thewonderidiot/agc_monitor/client/resources/dsky.png

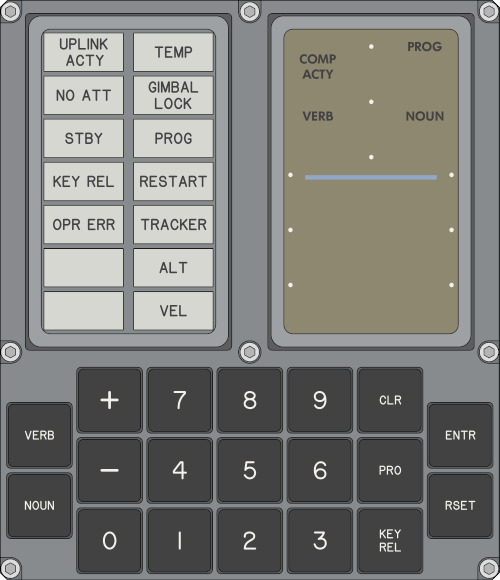
client/resources/dsky.png
