thewonderidiot/agc_monitor/client/resources/lamps.png

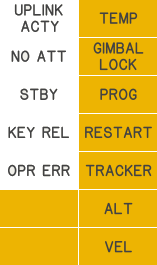
client/resources/lamps.png
