thewonderidiot/agc_monitor/(threads)

Thread 1 (2019-07-14):

Question: Using with yaAGC (virtual AGC)

jhuscott, 2019-07-14:
Hello,
Not having an FPGA to program at the moment (and looking at your files, it looks like a Styx Zynq 7020?), I am wondering if it is possible to point this monitor at yaAGC to debug and step through code.
I see you added code for NASSP, which uses yaAGC, but it looks to me that it is communicating with your actual AGC and not the simulated version.
Cheers.

meltdown03, 2022-07-04:
I was wondering the same thing. Do you also know if it's possible to use VirtualAGC to control Orbiter 2016 like in the videos of you landing on the (simulated) moon with the real AGC?

thewonderidiot, 2022-07-04:
Oops, I missed the original question here. :grimacing: Sorry! To answer both questions:

- No, it's not possible to point the monitor at yaAGC. yaAGC is an instruction-level emulator of the AGC; but in the real AGC, instructions are made up of 1-memory-cycle-time chunks called "subinstructions", which in turn are each made up of 12 "timepulses" that time execution of each subinstruction's control pulses (sort of like microcode -- see [AGC4 Memo #9](https://www.ibiblio.org/apollo/Documents/agc4_memo9_rev_june1967.pdf) for the control pulse definitions for each subinstruction). The test connector on the AGC directly exposes many of these control pulses as well as the contents of the "write bus" across which most data in the computer flows. Using that information, the monitor is able to reconstruct what's going on inside the computer. Much of the Monitor control panel and logic is based around this internal architecture, so it would be very difficult to interface it with an emulator that does not simulate this internal architecture... and if you did, a lot of the controls probably wouldn't work correctly.
- @meltdown03 for your second question -- the NASSP plugin already runs yaAGC out of the box! The installation guide is [here on the Orbiter forum](https://www.orbiter-forum.com/threads/nassp-8-installation-guide.36801/).

meltdown03, 2022-07-12:
Thanks for the info. Do all the missions use real AGC code now? I read on https://nassp.space/index.php?title=First_Steps that only some use the Virtual AGC.
