thewonderidiot/agc_monitor/board/agc_monitor.kicad_pcb

## KiCad design board/agc_monitor.kicad_pcb (2019-04-02)

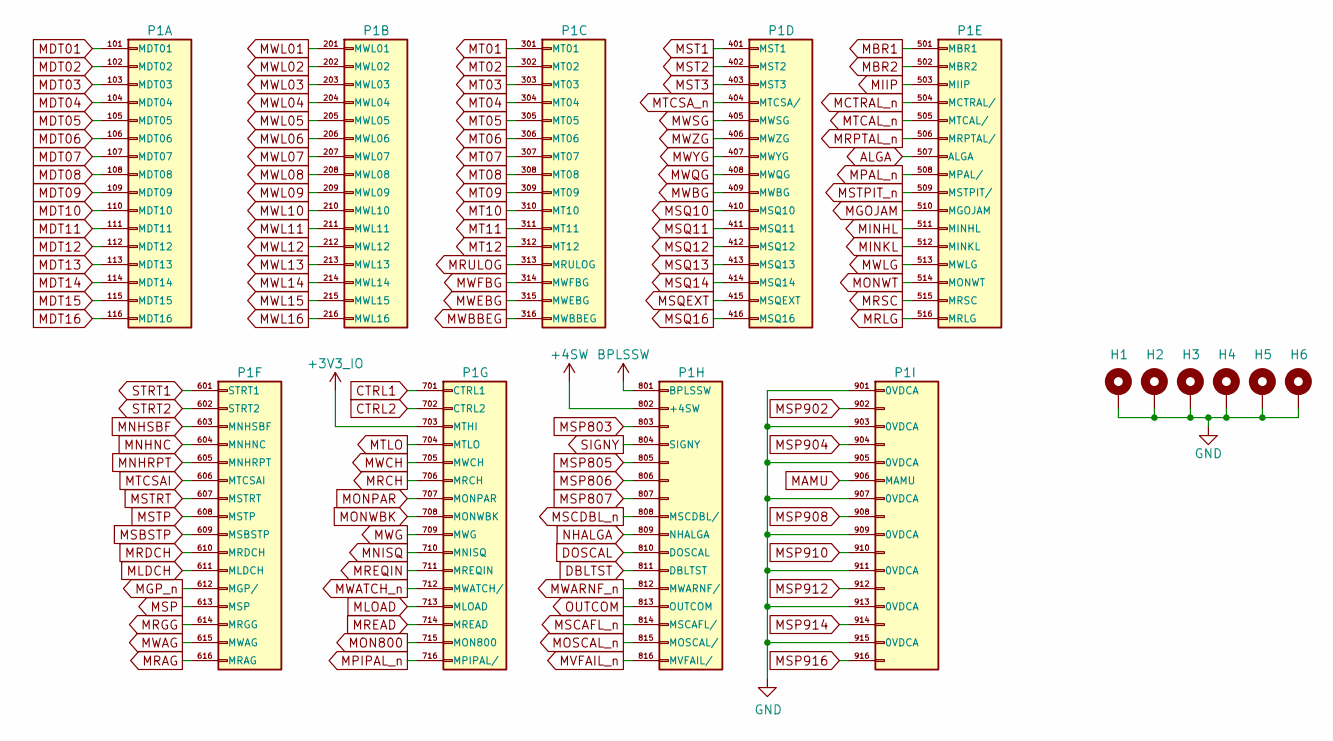
[picture p3: schematic test_connector.sch]

Parts:
H1, H2, H3, H4, H5, H6: MountingHole_Pad; MountingHole_ANSI_4
P1: test_connector

Connections:
+3V3_IO: P1.703 (MTHI); also elsewhere on the board
+4SW: P1.802 (+4SW); also elsewhere on the board
ALGA: P1.507 (ALGA); also elsewhere on the board
BPLSSW: P1.801 (BPLSSW); also elsewhere on the board
CTRL1: P1.701 (CTRL1); also elsewhere on the board
CTRL2: P1.702 (CTRL2); also elsewhere on the board
DBLTST: P1.811 (DBLTST); also elsewhere on the board
DOSCAL: P1.810 (DOSCAL); also elsewhere on the board
GND: H1.1, H2.1, H3.1, H4.1, H5.1, H6.1, P1.901 (0VDCA), P1.903 (0VDCA), P1.905 (0VDCA), P1.907 (0VDCA), P1.909 (0VDCA), P1.911 (0VDCA), P1.913 (0VDCA), P1.915 (0VDCA); also elsewhere on the board
MAMU: P1.906 (MAMU); also elsewhere on the board
MBR1: P1.501 (MBR1); also elsewhere on the board
MBR2: P1.502 (MBR2); also elsewhere on the board
MCTRAL_n: P1.504 (MCTRAL/); also elsewhere on the board
MDT01: P1.101 (MDT01); also elsewhere on the board
MDT02: P1.102 (MDT02); also elsewhere on the board
MDT03: P1.103 (MDT03); also elsewhere on the board
MDT04: P1.104 (MDT04); also elsewhere on the board
MDT05: P1.105 (MDT05); also elsewhere on the board
MDT06: P1.106 (MDT06); also elsewhere on the board
MDT07: P1.107 (MDT07); also elsewhere on the board
MDT08: P1.108 (MDT08); also elsewhere on the board
MDT09: P1.109 (MDT09); also elsewhere on the board
MDT10: P1.110 (MDT10); also elsewhere on the board
MDT11: P1.111 (MDT11); also elsewhere on the board
MDT12: P1.112 (MDT12); also elsewhere on the board
MDT13: P1.113 (MDT13); also elsewhere on the board
MDT14: P1.114 (MDT14); also elsewhere on the board
MDT15: P1.115 (MDT15); also elsewhere on the board
MDT16: P1.116 (MDT16); also elsewhere on the board
MGOJAM: P1.510 (MGOJAM); also elsewhere on the board
MGP_n: P1.612 (MGP/); also elsewhere on the board
MIIP: P1.503 (MIIP); also elsewhere on the board
MINHL: P1.511 (MINHL); also elsewhere on the board
MINKL: P1.512 (MINKL); also elsewhere on the board
MLDCH: P1.611 (MLDCH); also elsewhere on the board
MLOAD: P1.713 (MLOAD); also elsewhere on the board
MNHNC: P1.604 (MNHNC); also elsewhere on the board
MNHRPT: P1.605 (MNHRPT); also elsewhere on the board
MNHSBF: P1.603 (MNHSBF); also elsewhere on the board
MNISQ: P1.710 (MNISQ); also elsewhere on the board
MON800: P1.715 (MON800); also elsewhere on the board
MONPAR: P1.707 (MONPAR); also elsewhere on the board
MONWBK: P1.708 (MONWBK); also elsewhere on the board
MONWT: P1.514 (MONWT); also elsewhere on the board
MOSCAL_n: P1.815 (MOSCAL/); also elsewhere on the board
MPAL_n: P1.508 (MPAL/); also elsewhere on the board
MPIPAL_n: P1.716 (MPIPAL/); also elsewhere on the board
MRAG: P1.616 (MRAG); also elsewhere on the board
MRCH: P1.706 (MRCH); also elsewhere on the board
MRDCH: P1.610 (MRDCH); also elsewhere on the board
MREAD: P1.714 (MREAD); also elsewhere on the board
MREQIN: P1.711 (MREQIN); also elsewhere on the board
MRGG: P1.614 (MRGG); also elsewhere on the board
MRLG: P1.516 (MRLG); also elsewhere on the board
MRPTAL_n: P1.506 (MRPTAL/); also elsewhere on the board
MRSC: P1.515 (MRSC); also elsewhere on the board
MRULOG: P1.313 (MRULOG); also elsewhere on the board
MSBSTP: P1.609 (MSBSTP); also elsewhere on the board
MSCAFL_n: P1.814 (MSCAFL/); also elsewhere on the board
MSCDBL_n: P1.808 (MSCDBL/); also elsewhere on the board
MSP: P1.613 (MSP); also elsewhere on the board
MSP803: P1.803; also elsewhere on the board
MSP805: P1.805; also elsewhere on the board
MSP806: P1.806; also elsewhere on the board
MSP807: P1.807; also elsewhere on the board
MSP902: P1.902; also elsewhere on the board
MSP904: P1.904; also elsewhere on the board
MSP908: P1.908; also elsewhere on the board
MSP910: P1.910; also elsewhere on the board
MSP912: P1.912; also elsewhere on the board
MSP914: P1.914; also elsewhere on the board
MSP916: P1.916; also elsewhere on the board
MSQ10: P1.410 (MSQ10); also elsewhere on the board
MSQ11: P1.411 (MSQ11); also elsewhere on the board
MSQ12: P1.412 (MSQ12); also elsewhere on the board
MSQ13: P1.413 (MSQ13); also elsewhere on the board
MSQ14: P1.414 (MSQ14); also elsewhere on the board
MSQ16: P1.416 (MSQ16); also elsewhere on the board
MSQEXT: P1.415 (MSQEXT); also elsewhere on the board
MST1: P1.401 (MST1); also elsewhere on the board
MST2: P1.402 (MST2); also elsewhere on the board
MST3: P1.403 (MST3); also elsewhere on the board
MSTP: P1.608 (MSTP); also elsewhere on the board
MSTPIT_n: P1.509 (MSTPIT/); also elsewhere on the board
MSTRT: P1.607 (MSTRT); also elsewhere on the board
MT01: P1.301 (MT01); also elsewhere on the board
MT02: P1.302 (MT02); also elsewhere on the board
MT03: P1.303 (MT03); also elsewhere on the board
MT04: P1.304 (MT04); also elsewhere on the board
MT05: P1.305 (MT05); also elsewhere on the board
MT06: P1.306 (MT06); also elsewhere on the board
MT07: P1.307 (MT07); also elsewhere on the board
MT08: P1.308 (MT08); also elsewhere on the board
MT09: P1.309 (MT09); also elsewhere on the board
MT10: P1.310 (MT10); also elsewhere on the board
MT11: P1.311 (MT11); also elsewhere on the board
MT12: P1.312 (MT12); also elsewhere on the board
MTCAL_n: P1.505 (MTCAL/); also elsewhere on the board
MTCSAI: P1.606 (MTCSAI); also elsewhere on the board
MTCSA_n: P1.404 (MTCSA/); also elsewhere on the board
MTLO: P1.704 (MTLO); also elsewhere on the board
MVFAIL_n: P1.816 (MVFAIL/); also elsewhere on the board
MWAG: P1.615 (MWAG); also elsewhere on the board
MWARNF_n: P1.812 (MWARNF/); also elsewhere on the board
MWATCH_n: P1.712 (MWATCH/); also elsewhere on the board
MWBBEG: P1.316 (MWBBEG); also elsewhere on the board
MWBG: P1.409 (MWBG); also elsewhere on the board
MWCH: P1.705 (MWCH); also elsewhere on the board
MWEBG: P1.315 (MWEBG); also elsewhere on the board
MWFBG: P1.314 (MWFBG); also elsewhere on the board
MWG: P1.709 (MWG); also elsewhere on the board
MWL01: P1.201 (MWL01); also elsewhere on the board
MWL02: P1.202 (MWL02); also elsewhere on the board
MWL03: P1.203 (MWL03); also elsewhere on the board
MWL04: P1.204 (MWL04); also elsewhere on the board
MWL05: P1.205 (MWL05); also elsewhere on the board
MWL06: P1.206 (MWL06); also elsewhere on the board
MWL07: P1.207 (MWL07); also elsewhere on the board
MWL08: P1.208 (MWL08); also elsewhere on the board
MWL09: P1.209 (MWL09); also elsewhere on the board
MWL10: P1.210 (MWL10); also elsewhere on the board
MWL11: P1.211 (MWL11); also elsewhere on the board
MWL12: P1.212 (MWL12); also elsewhere on the board
MWL13: P1.213 (MWL13); also elsewhere on the board
MWL14: P1.214 (MWL14); also elsewhere on the board
MWL15: P1.215 (MWL15); also elsewhere on the board
MWL16: P1.216 (MWL16); also elsewhere on the board
MWLG: P1.513 (MWLG); also elsewhere on the board
MWQG: P1.408 (MWQG); also elsewhere on the board
MWSG: P1.405 (MWSG); also elsewhere on the board
MWYG: P1.407 (MWYG); also elsewhere on the board
MWZG: P1.406 (MWZG); also elsewhere on the board
NHALGA: P1.809 (NHALGA); also elsewhere on the board
OUTCOM: P1.813 (OUTCOM); also elsewhere on the board
SIGNY: P1.804 (SIGNY); also elsewhere on the board
STRT1: P1.601 (STRT1); also elsewhere on the board
STRT2: P1.602 (STRT2); also elsewhere on the board

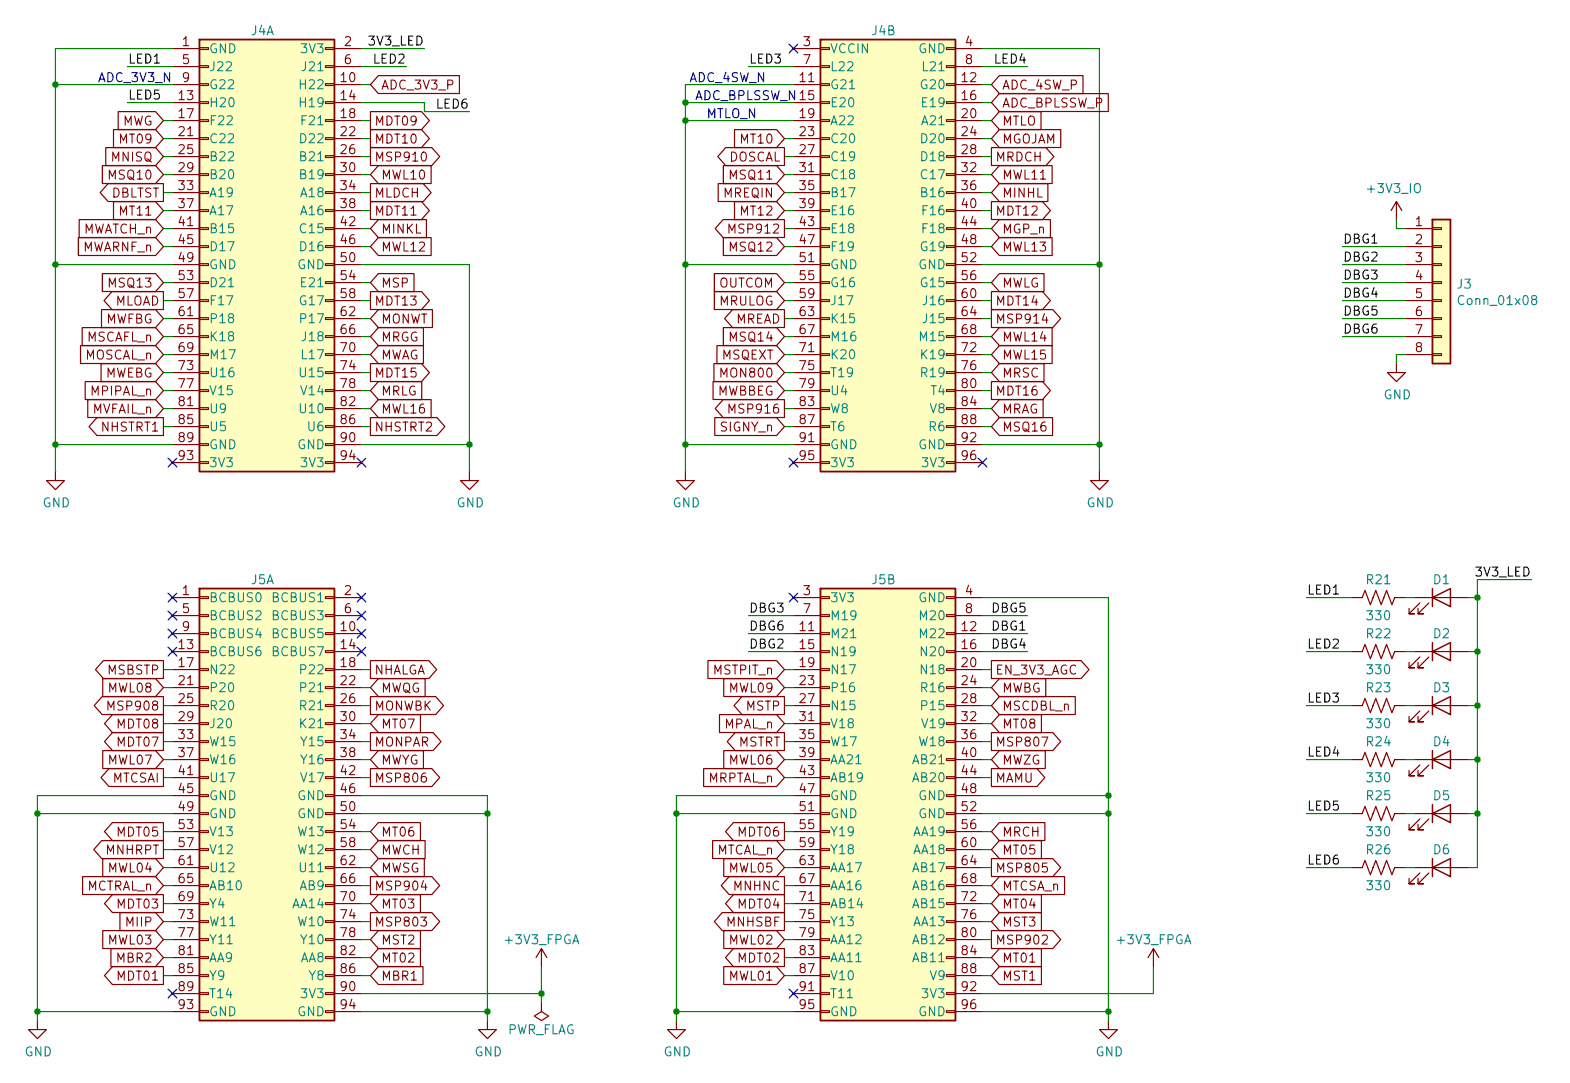
[picture p4: schematic styx_connectors.sch]

Parts:
D1, D2, D3, D4, D5, D6: LED; LED_0603_1608Metric
J3: Conn_01x08; PinSocket_2x04_P2.54mm_Horizontal
J4: Styx_P4; PinHeader_4x24_P2.54mm_Vertical
J5: Styx_P5; PinHeader_4x24_P2.54mm_Vertical
R21, R22, R23, R24, R25, R26: 330; R_0603_1608Metric

Connections:
+3V3_FPGA: J5.90 (3V3), J5.92 (3V3); also elsewhere on the board
+3V3_IO: J3.1; also elsewhere on the board
/StyxConnectors/3V3_LED: D1.2 (A), D2.2 (A), D3.2 (A), D4.2 (A), D5.2 (A), D6.2 (A), J4.2 (3V3)
/StyxConnectors/DBG1: J3.2, J5.12 (M22)
/StyxConnectors/DBG2: J3.3, J5.15 (N19)
/StyxConnectors/DBG3: J3.4, J5.7 (M19)
/StyxConnectors/DBG4: J3.5, J5.16 (N20)
/StyxConnectors/DBG5: J3.6, J5.8 (M20)
/StyxConnectors/DBG6: J3.7, J5.11 (M21)
/StyxConnectors/LED1: J4.5 (J22), R21.2
/StyxConnectors/LED2: J4.6 (J21), R22.2
/StyxConnectors/LED3: J4.7 (L22), R23.2
/StyxConnectors/LED4: J4.8 (L21), R24.2
/StyxConnectors/LED5: J4.13 (H20), R25.2
/StyxConnectors/LED6: J4.14 (H19), R26.2
ADC_3V3_P: J4.10 (H22); also elsewhere on the board
ADC_4SW_P: J4.12 (G20); also elsewhere on the board
ADC_BPLSSW_P: J4.16 (E19); also elsewhere on the board
DBLTST: J4.33 (A19); also elsewhere on the board
DOSCAL: J4.27 (C19); also elsewhere on the board
EN_3V3_AGC: J5.20 (N18); also elsewhere on the board
GND: J3.8, J4.1 (GND), J4.4 (GND), J4.9 (G22), J4.11 (G21), J4.15 (E20), J4.19 (A22), J4.49 (GND), J4.50 (GND), J4.51 (GND), J4.52 (GND), J4.89 (GND), J4.90 (GND), J4.91 (GND), J4.92 (GND), J5.4 (GND), J5.45 (GND), J5.46 (GND), J5.47 (GND), J5.48 (GND), J5.49 (GND), J5.50 (GND), J5.51 (GND), J5.52 (GND), J5.93 (GND), J5.94 (GND), J5.95 (GND), J5.96 (GND); also elsewhere on the board
MAMU: J5.44 (AB20); also elsewhere on the board
MBR1: J5.86 (Y8); also elsewhere on the board
MBR2: J5.81 (AA9); also elsewhere on the board
MCTRAL_n: J5.65 (AB10); also elsewhere on the board
MDT01: J5.85 (Y9); also elsewhere on the board
MDT02: J5.83 (AA11); also elsewhere on the board
MDT03: J5.69 (Y4); also elsewhere on the board
MDT04: J5.71 (AB14); also elsewhere on the board
MDT05: J5.53 (V13); also elsewhere on the board
MDT06: J5.55 (Y19); also elsewhere on the board
MDT07: J5.33 (W15); also elsewhere on the board
MDT08: J5.29 (J20); also elsewhere on the board
MDT09: J4.18 (F21); also elsewhere on the board
MDT10: J4.22 (D22); also elsewhere on the board
MDT11: J4.38 (A16); also elsewhere on the board
MDT12: J4.40 (F16); also elsewhere on the board
MDT13: J4.58 (G17); also elsewhere on the board
MDT14: J4.60 (J16); also elsewhere on the board
MDT15: J4.74 (U15); also elsewhere on the board
MDT16: J4.80 (T4); also elsewhere on the board
MGOJAM: J4.24 (D20); also elsewhere on the board
MGP_n: J4.44 (F18); also elsewhere on the board
MIIP: J5.73 (W11); also elsewhere on the board
MINHL: J4.36 (B16); also elsewhere on the board
MINKL: J4.42 (C15); also elsewhere on the board
MLDCH: J4.34 (A18); also elsewhere on the board
MLOAD: J4.57 (F17); also elsewhere on the board
MNHNC: J5.67 (AA16); also elsewhere on the board
MNHRPT: J5.57 (V12); also elsewhere on the board
MNHSBF: J5.75 (Y13); also elsewhere on the board
MNISQ: J4.25 (B22); also elsewhere on the board
MON800: J4.75 (T19); also elsewhere on the board
MONPAR: J5.34 (Y15); also elsewhere on the board
MONWBK: J5.26 (R21); also elsewhere on the board
MONWT: J4.62 (P17); also elsewhere on the board
MOSCAL_n: J4.69 (M17); also elsewhere on the board
MPAL_n: J5.31 (V18); also elsewhere on the board
MPIPAL_n: J4.77 (V15); also elsewhere on the board
MRAG: J4.84 (V8); also elsewhere on the board
MRCH: J5.56 (AA19); also elsewhere on the board
MRDCH: J4.28 (D18); also elsewhere on the board
MREAD: J4.63 (K15); also elsewhere on the board
MREQIN: J4.35 (B17); also elsewhere on the board
MRGG: J4.66 (J18); also elsewhere on the board
MRLG: J4.78 (V14); also elsewhere on the board
MRPTAL_n: J5.43 (AB19); also elsewhere on the board
MRSC: J4.76 (R19); also elsewhere on the board
MRULOG: J4.59 (J17); also elsewhere on the board
MSBSTP: J5.17 (N22); also elsewhere on the board
MSCAFL_n: J4.65 (K18); also elsewhere on the board
MSCDBL_n: J5.28 (P15); also elsewhere on the board
MSP: J4.54 (E21); also elsewhere on the board
MSP803: J5.74 (W10); also elsewhere on the board
MSP805: J5.64 (AB17); also elsewhere on the board
MSP806: J5.42 (V17); also elsewhere on the board
MSP807: J5.36 (W18); also elsewhere on the board
MSP902: J5.80 (AB12); also elsewhere on the board
MSP904: J5.66 (AB9); also elsewhere on the board
MSP908: J5.25 (R20); also elsewhere on the board
MSP910: J4.26 (B21); also elsewhere on the board
MSP912: J4.43 (E18); also elsewhere on the board
MSP914: J4.64 (J15); also elsewhere on the board
MSP916: J4.83 (W8); also elsewhere on the board
MSQ10: J4.29 (B20); also elsewhere on the board
MSQ11: J4.31 (C18); also elsewhere on the board
MSQ12: J4.47 (F19); also elsewhere on the board
MSQ13: J4.53 (D21); also elsewhere on the board
MSQ14: J4.67 (M16); also elsewhere on the board
MSQ16: J4.88 (R6); also elsewhere on the board
MSQEXT: J4.71 (K20); also elsewhere on the board
MST1: J5.88 (V9); also elsewhere on the board
MST2: J5.78 (Y10); also elsewhere on the board
MST3: J5.76 (AA13); also elsewhere on the board
MSTP: J5.27 (N15); also elsewhere on the board
MSTPIT_n: J5.19 (N17); also elsewhere on the board
MSTRT: J5.35 (W17); also elsewhere on the board
MT01: J5.84 (AB11); also elsewhere on the board
MT02: J5.82 (AA8); also elsewhere on the board
MT03: J5.70 (AA14); also elsewhere on the board
MT04: J5.72 (AB15); also elsewhere on the board
MT05: J5.60 (AA18); also elsewhere on the board
MT06: J5.54 (W13); also elsewhere on the board
MT07: J5.30 (K21); also elsewhere on the board
MT08: J5.32 (V19); also elsewhere on the board
MT09: J4.21 (C22); also elsewhere on the board
MT10: J4.23 (C20); also elsewhere on the board
MT11: J4.37 (A17); also elsewhere on the board
MT12: J4.39 (E16); also elsewhere on the board
MTCAL_n: J5.59 (Y18); also elsewhere on the board
MTCSAI: J5.41 (U17); also elsewhere on the board
MTCSA_n: J5.68 (AB16); also elsewhere on the board
MTLO: J4.20 (A21); also elsewhere on the board
MVFAIL_n: J4.81 (U9); also elsewhere on the board
MWAG: J4.70 (L17); also elsewhere on the board
MWARNF_n: J4.45 (D17); also elsewhere on the board
MWATCH_n: J4.41 (B15); also elsewhere on the board
MWBBEG: J4.79 (U4); also elsewhere on the board
MWBG: J5.24 (R16); also elsewhere on the board
MWCH: J5.58 (W12); also elsewhere on the board
MWEBG: J4.73 (U16); also elsewhere on the board
MWFBG: J4.61 (P18); also elsewhere on the board
MWG: J4.17 (F22); also elsewhere on the board
MWL01: J5.87 (V10); also elsewhere on the board
MWL02: J5.79 (AA12); also elsewhere on the board
MWL03: J5.77 (Y11); also elsewhere on the board
MWL04: J5.61 (U12); also elsewhere on the board
MWL05: J5.63 (AA17); also elsewhere on the board
MWL06: J5.39 (AA21); also elsewhere on the board
MWL07: J5.37 (W16); also elsewhere on the board
MWL08: J5.21 (P20); also elsewhere on the board
MWL09: J5.23 (P16); also elsewhere on the board
MWL10: J4.30 (B19); also elsewhere on the board
MWL11: J4.32 (C17); also elsewhere on the board
MWL12: J4.46 (D16); also elsewhere on the board
MWL13: J4.48 (G19); also elsewhere on the board
MWL14: J4.68 (M15); also elsewhere on the board
MWL15: J4.72 (K19); also elsewhere on the board
MWL16: J4.82 (U10); also elsewhere on the board
MWLG: J4.56 (G15); also elsewhere on the board
MWQG: J5.22 (P21); also elsewhere on the board
MWSG: J5.62 (U11); also elsewhere on the board
MWYG: J5.38 (Y16); also elsewhere on the board
MWZG: J5.40 (AB21); also elsewhere on the board
NHALGA: J5.18 (P22); also elsewhere on the board
NHSTRT1: J4.85 (U5); also elsewhere on the board
NHSTRT2: J4.86 (U6); also elsewhere on the board
unnamed: D1.1 (K), R21.1
unnamed: D2.1 (K), R22.1
unnamed: D3.1 (K), R23.1
unnamed: D4.1 (K), R24.1
unnamed: D5.1 (K), R25.1
unnamed: D6.1 (K), R26.1
OUTCOM: J4.55 (G16); also elsewhere on the board
SIGNY_n: J4.87 (T6); also elsewhere on the board

Notes on the sheet:
ADC_BPLSSW_N
ADC_4SW_N
MTLO_N
ADC_3V3_N

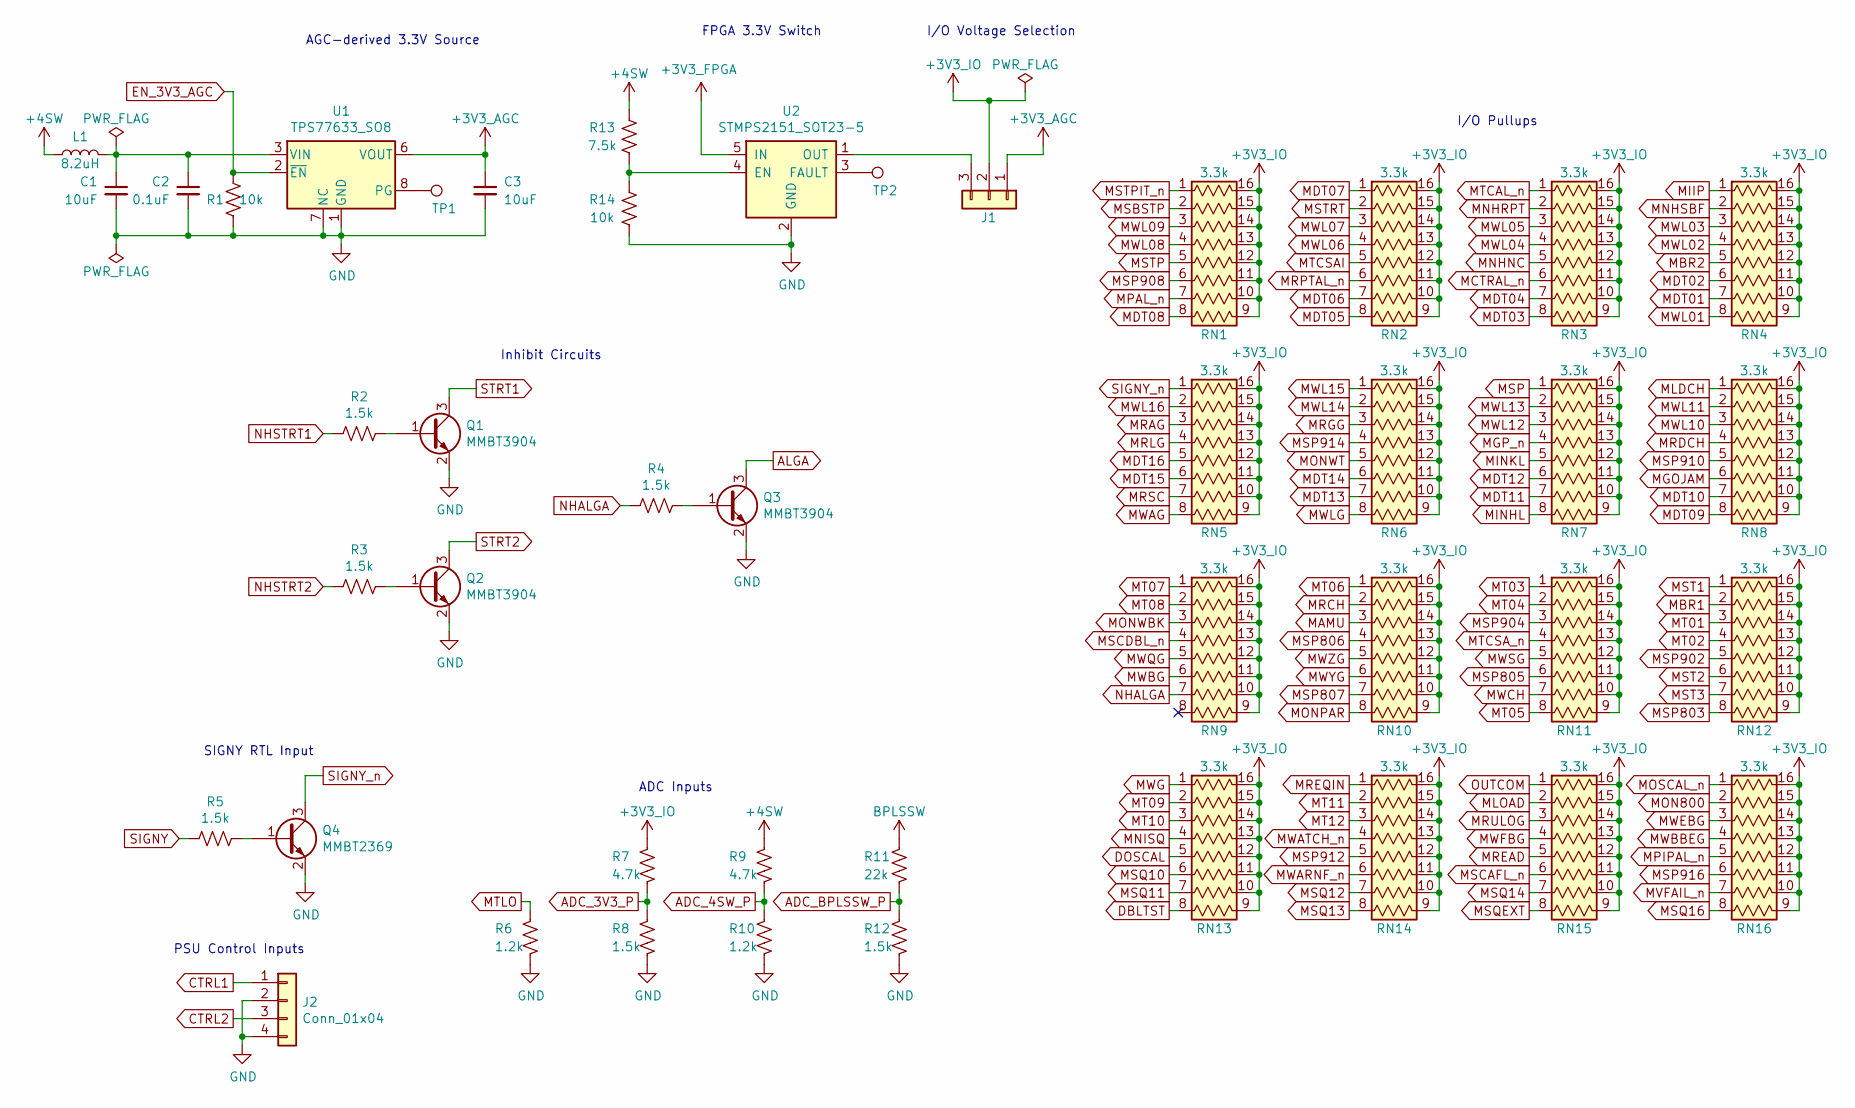
[picture p5: schematic interface_circuits.sch]

Parts:
C1, C3: 10uF; C_1206_3216Metric
C2: 0.1uF; C_0603_1608Metric
J1: Conn_01x03; PinHeader_1x03_P2.00mm_Vertical
J2: Conn_01x04; PinSocket_2x02_P2.54mm_Horizontal
L1: 8.2uH; L_1812_4532Metric
Q1, Q2, Q3: MMBT3904; SOT-23
Q4: MMBT2369; SOT-23
R1, R14: 10k; R_0603_1608Metric
R2, R3, R4, R5, R8, R12: 1.5k; R_0603_1608Metric
R6, R10: 1.2k; R_0603_1608Metric
R7, R9: 4.7k; R_0603_1608Metric
R11: 22k; R_0603_1608Metric
R13: 7.5k; R_0603_1608Metric
RN1, RN2, RN3, RN4, RN5, RN6, RN7, RN8, RN9, RN10, RN11, RN12, RN13, RN14, RN15, RN16: 3.3k; SOIC-16W_5.3x10.2mm_P1.27mm
TP1, TP2: TestPoint; TestPoint_Pad_D1.0mm
U1: TPS77633_SO8; SOIC-8_3.9x4.9mm_P1.27mm
U2: STMPS2151_SOT23-5; SOT-23-5

Connections:
+3V3_AGC: C3.1, J1.1, U1.5 (VOUT), U1.6 (VOUT)
+3V3_FPGA: U2.5 (IN); also elsewhere on the board
+3V3_IO: J1.2, R7.1, RN1.9 (R8B), RN1.10 (R7B), RN1.11 (R6B), RN1.12 (R5B), RN1.13 (R4B), RN1.14 (R3B), RN1.15 (R2B), RN1.16 (R1B), RN2.9 (R8B), RN2.10 (R7B), RN2.11 (R6B), RN2.12 (R5B), RN2.13 (R4B), RN2.14 (R3B), RN2.15 (R2B), RN2.16 (R1B), RN3.9 (R8B), RN3.10 (R7B), RN3.11 (R6B), RN3.12 (R5B), RN3.13 (R4B), RN3.14 (R3B), RN3.15 (R2B), RN3.16 (R1B), RN4.9 (R8B), RN4.10 (R7B), RN4.11 (R6B), RN4.12 (R5B), RN4.13 (R4B), RN4.14 (R3B), RN4.15 (R2B), RN4.16 (R1B), RN5.9 (R8B), RN5.10 (R7B), RN5.11 (R6B), RN5.12 (R5B), RN5.13 (R4B), RN5.14 (R3B), RN5.15 (R2B), RN5.16 (R1B), RN6.9 (R8B), RN6.10 (R7B), RN6.11 (R6B), RN6.12 (R5B), RN6.13 (R4B), RN6.14 (R3B), RN6.15 (R2B), RN6.16 (R1B), RN7.9 (R8B), RN7.10 (R7B), RN7.11 (R6B), RN7.12 (R5B), RN7.13 (R4B), RN7.14 (R3B), RN7.15 (R2B), RN7.16 (R1B), RN8.9 (R8B), RN8.10 (R7B), RN8.11 (R6B), RN8.12 (R5B), RN8.13 (R4B), RN8.14 (R3B), RN8.15 (R2B), RN8.16 (R1B), RN9.9 (R8B), RN9.10 (R7B), RN9.11 (R6B), RN9.12 (R5B), RN9.13 (R4B), RN9.14 (R3B), RN9.15 (R2B), RN9.16 (R1B), RN10.9 (R8B), RN10.10 (R7B), RN10.11 (R6B), RN10.12 (R5B), RN10.13 (R4B), RN10.14 (R3B), RN10.15 (R2B), RN10.16 (R1B), RN11.9 (R8B), RN11.10 (R7B), RN11.11 (R6B), RN11.12 (R5B), RN11.13 (R4B), RN11.14 (R3B), RN11.15 (R2B), RN11.16 (R1B), RN12.9 (R8B), RN12.10 (R7B), RN12.11 (R6B), RN12.12 (R5B), RN12.13 (R4B), RN12.14 (R3B), RN12.15 (R2B), RN12.16 (R1B), RN13.9 (R8B), RN13.10 (R7B), RN13.11 (R6B), RN13.12 (R5B), RN13.13 (R4B), RN13.14 (R3B), RN13.15 (R2B), RN13.16 (R1B), RN14.9 (R8B), RN14.10 (R7B), RN14.11 (R6B), RN14.12 (R5B), RN14.13 (R4B), RN14.14 (R3B), RN14.15 (R2B), RN14.16 (R1B), RN15.9 (R8B), RN15.10 (R7B), RN15.11 (R6B), RN15.12 (R5B), RN15.13 (R4B), RN15.14 (R3B), RN15.15 (R2B), RN15.16 (R1B), RN16.9 (R8B), RN16.10 (R7B), RN16.11 (R6B), RN16.12 (R5B), RN16.13 (R4B), RN16.14 (R3B), RN16.15 (R2B), RN16.16 (R1B); also elsewhere on the board
+4SW: L1.1, R9.1, R13.1; also elsewhere on the board
ADC_3V3_P: R7.2, R8.1; also elsewhere on the board
ADC_4SW_P: R9.2, R10.1; also elsewhere on the board
ADC_BPLSSW_P: R11.2, R12.1; also elsewhere on the board
ALGA: Q3.3 (C); also elsewhere on the board
BPLSSW: R11.1; also elsewhere on the board
CTRL1: J2.1; also elsewhere on the board
CTRL2: J2.3; also elsewhere on the board
DBLTST: RN13.8 (R8A); also elsewhere on the board
DOSCAL: RN13.5 (R5A); also elsewhere on the board
EN_3V3_AGC: R1.1, U1.2 (~EN~); also elsewhere on the board
GND: C1.2, C2.2, C3.2, J2.2, J2.4, Q1.2 (E), Q2.2 (E), Q3.2 (E), Q4.2 (E), R1.2, R6.2, R8.2, R10.2, R12.2, R14.2, U1.1 (GND), U1.7 (NC), U2.2 (GND); also elsewhere on the board
MAMU: RN10.3 (R3A); also elsewhere on the board
MBR1: RN12.2 (R2A); also elsewhere on the board
MBR2: RN4.5 (R5A); also elsewhere on the board
MCTRAL_n: RN3.6 (R6A); also elsewhere on the board
MDT01: RN4.7 (R7A); also elsewhere on the board
MDT02: RN4.6 (R6A); also elsewhere on the board
MDT03: RN3.8 (R8A); also elsewhere on the board
MDT04: RN3.7 (R7A); also elsewhere on the board
MDT05: RN2.8 (R8A); also elsewhere on the board
MDT06: RN2.7 (R7A); also elsewhere on the board
MDT07: RN2.1 (R1A); also elsewhere on the board
MDT08: RN1.8 (R8A); also elsewhere on the board
MDT09: RN8.8 (R8A); also elsewhere on the board
MDT10: RN8.7 (R7A); also elsewhere on the board
MDT11: RN7.7 (R7A); also elsewhere on the board
MDT12: RN7.6 (R6A); also elsewhere on the board
MDT13: RN6.7 (R7A); also elsewhere on the board
MDT14: RN6.6 (R6A); also elsewhere on the board
MDT15: RN5.6 (R6A); also elsewhere on the board
MDT16: RN5.5 (R5A); also elsewhere on the board
MGOJAM: RN8.6 (R6A); also elsewhere on the board
MGP_n: RN7.4 (R4A); also elsewhere on the board
MIIP: RN4.1 (R1A); also elsewhere on the board
MINHL: RN7.8 (R8A); also elsewhere on the board
MINKL: RN7.5 (R5A); also elsewhere on the board
MLDCH: RN8.1 (R1A); also elsewhere on the board
MLOAD: RN15.2 (R2A); also elsewhere on the board
MNHNC: RN3.5 (R5A); also elsewhere on the board
MNHRPT: RN3.2 (R2A); also elsewhere on the board
MNHSBF: RN4.2 (R2A); also elsewhere on the board
MNISQ: RN13.4 (R4A); also elsewhere on the board
MON800: RN16.2 (R2A); also elsewhere on the board
MONPAR: RN10.8 (R8A); also elsewhere on the board
MONWBK: RN9.3 (R3A); also elsewhere on the board
MONWT: RN6.5 (R5A); also elsewhere on the board
MOSCAL_n: RN16.1 (R1A); also elsewhere on the board
MPAL_n: RN1.7 (R7A); also elsewhere on the board
MPIPAL_n: RN16.5 (R5A); also elsewhere on the board
MRAG: RN5.3 (R3A); also elsewhere on the board
MRCH: RN10.2 (R2A); also elsewhere on the board
MRDCH: RN8.4 (R4A); also elsewhere on the board
MREAD: RN15.5 (R5A); also elsewhere on the board
MREQIN: RN14.1 (R1A); also elsewhere on the board
MRGG: RN6.3 (R3A); also elsewhere on the board
MRLG: RN5.4 (R4A); also elsewhere on the board
MRPTAL_n: RN2.6 (R6A); also elsewhere on the board
MRSC: RN5.7 (R7A); also elsewhere on the board
MRULOG: RN15.3 (R3A); also elsewhere on the board
MSBSTP: RN1.2 (R2A); also elsewhere on the board
MSCAFL_n: RN15.6 (R6A); also elsewhere on the board
MSCDBL_n: RN9.4 (R4A); also elsewhere on the board
MSP: RN7.1 (R1A); also elsewhere on the board
MSP803: RN12.8 (R8A); also elsewhere on the board
MSP805: RN11.6 (R6A); also elsewhere on the board
MSP806: RN10.4 (R4A); also elsewhere on the board
MSP807: RN10.7 (R7A); also elsewhere on the board
MSP902: RN12.5 (R5A); also elsewhere on the board
MSP904: RN11.3 (R3A); also elsewhere on the board
MSP908: RN1.6 (R6A); also elsewhere on the board
MSP910: RN8.5 (R5A); also elsewhere on the board
MSP912: RN14.5 (R5A); also elsewhere on the board
MSP914: RN6.4 (R4A); also elsewhere on the board
MSP916: RN16.6 (R6A); also elsewhere on the board
MSQ10: RN13.6 (R6A); also elsewhere on the board
MSQ11: RN13.7 (R7A); also elsewhere on the board
MSQ12: RN14.7 (R7A); also elsewhere on the board
MSQ13: RN14.8 (R8A); also elsewhere on the board
MSQ14: RN15.7 (R7A); also elsewhere on the board
MSQ16: RN16.8 (R8A); also elsewhere on the board
MSQEXT: RN15.8 (R8A); also elsewhere on the board
MST1: RN12.1 (R1A); also elsewhere on the board
MST2: RN12.6 (R6A); also elsewhere on the board
MST3: RN12.7 (R7A); also elsewhere on the board
MSTP: RN1.5 (R5A); also elsewhere on the board
MSTPIT_n: RN1.1 (R1A); also elsewhere on the board
MSTRT: RN2.2 (R2A); also elsewhere on the board
MT01: RN12.3 (R3A); also elsewhere on the board
MT02: RN12.4 (R4A); also elsewhere on the board
MT03: RN11.1 (R1A); also elsewhere on the board
MT04: RN11.2 (R2A); also elsewhere on the board
MT05: RN11.8 (R8A); also elsewhere on the board
MT06: RN10.1 (R1A); also elsewhere on the board
MT07: RN9.1 (R1A); also elsewhere on the board
MT08: RN9.2 (R2A); also elsewhere on the board
MT09: RN13.2 (R2A); also elsewhere on the board
MT10: RN13.3 (R3A); also elsewhere on the board
MT11: RN14.2 (R2A); also elsewhere on the board
MT12: RN14.3 (R3A); also elsewhere on the board
MTCAL_n: RN3.1 (R1A); also elsewhere on the board
MTCSAI: RN2.5 (R5A); also elsewhere on the board
MTCSA_n: RN11.4 (R4A); also elsewhere on the board
MTLO: R6.1; also elsewhere on the board
MVFAIL_n: RN16.7 (R7A); also elsewhere on the board
MWAG: RN5.8 (R8A); also elsewhere on the board
MWARNF_n: RN14.6 (R6A); also elsewhere on the board
MWATCH_n: RN14.4 (R4A); also elsewhere on the board
MWBBEG: RN16.4 (R4A); also elsewhere on the board
MWBG: RN9.6 (R6A); also elsewhere on the board
MWCH: RN11.7 (R7A); also elsewhere on the board
MWEBG: RN16.3 (R3A); also elsewhere on the board
MWFBG: RN15.4 (R4A); also elsewhere on the board
MWG: RN13.1 (R1A); also elsewhere on the board
MWL01: RN4.8 (R8A); also elsewhere on the board
MWL02: RN4.4 (R4A); also elsewhere on the board
MWL03: RN4.3 (R3A); also elsewhere on the board
MWL04: RN3.4 (R4A); also elsewhere on the board
MWL05: RN3.3 (R3A); also elsewhere on the board
MWL06: RN2.4 (R4A); also elsewhere on the board
MWL07: RN2.3 (R3A); also elsewhere on the board
MWL08: RN1.4 (R4A); also elsewhere on the board
MWL09: RN1.3 (R3A); also elsewhere on the board
MWL10: RN8.3 (R3A); also elsewhere on the board
MWL11: RN8.2 (R2A); also elsewhere on the board
MWL12: RN7.3 (R3A); also elsewhere on the board
MWL13: RN7.2 (R2A); also elsewhere on the board
MWL14: RN6.2 (R2A); also elsewhere on the board
MWL15: RN6.1 (R1A); also elsewhere on the board
MWL16: RN5.2 (R2A); also elsewhere on the board
MWLG: RN6.8 (R8A); also elsewhere on the board
MWQG: RN9.5 (R5A); also elsewhere on the board
MWSG: RN11.5 (R5A); also elsewhere on the board
MWYG: RN10.6 (R6A); also elsewhere on the board
MWZG: RN10.5 (R5A); also elsewhere on the board
NHALGA: R4.2, RN9.7 (R7A); also elsewhere on the board
NHSTRT1: R2.2; also elsewhere on the board
NHSTRT2: R3.2; also elsewhere on the board
unnamed: C1.1, C2.1, L1.2, U1.3 (VIN), U1.4 (VIN)
unnamed: J1.3, U2.1 (OUT)
unnamed: Q1.1 (B), R2.1
unnamed: Q2.1 (B), R3.1
unnamed: Q3.1 (B), R4.1
unnamed: Q4.1 (B), R5.1
unnamed: R13.2, R14.1, U2.4 (EN)
unnamed: TP1.1, U1.8 (PG)
unnamed: TP2.1, U2.3 (FAULT)
OUTCOM: RN15.1 (R1A); also elsewhere on the board
SIGNY: R5.2; also elsewhere on the board
SIGNY_n: Q4.3 (C), RN5.1 (R1A); also elsewhere on the board
STRT1: Q1.3 (C); also elsewhere on the board
STRT2: Q2.3 (C); also elsewhere on the board

Notes on the sheet:
AGC-derived 3.3V Source
I/O Voltage Selection
ADC Inputs
I/O Pullups
Inhibit Circuits
PSU Control Inputs
SIGNY RTL Input
FPGA 3.3V Switch

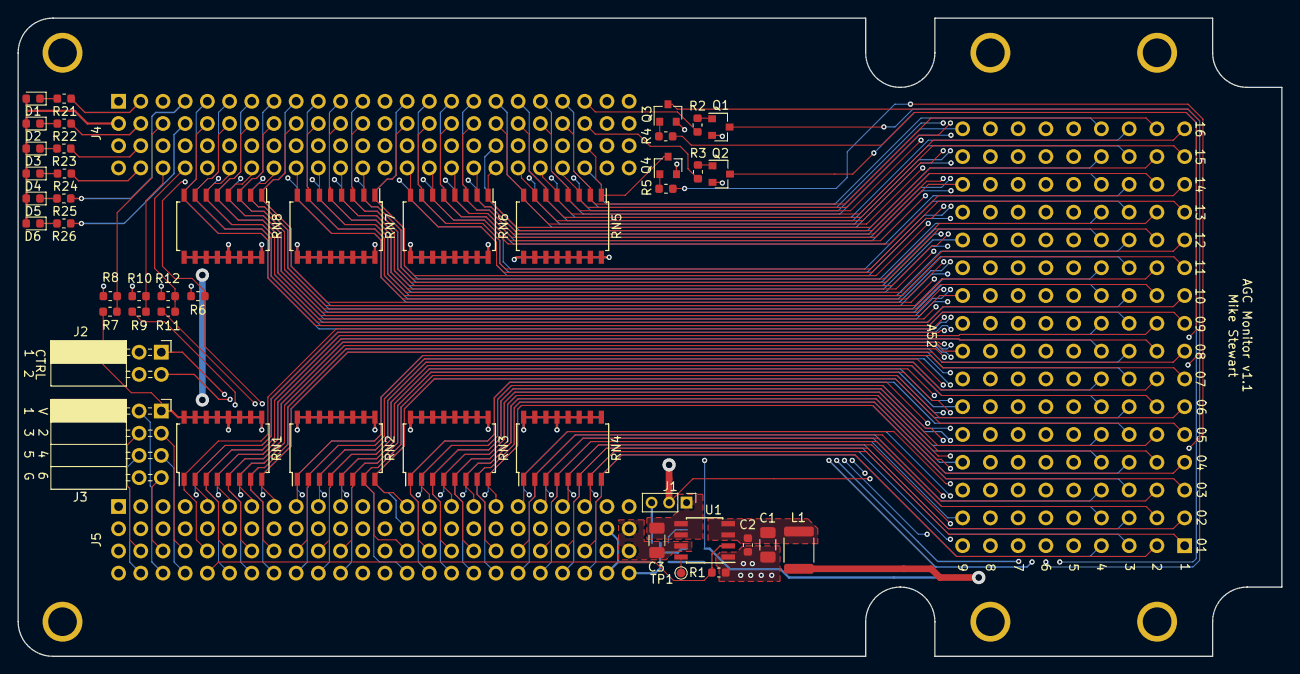
[picture p6: board agc_monitor.kicad_pcb from above]

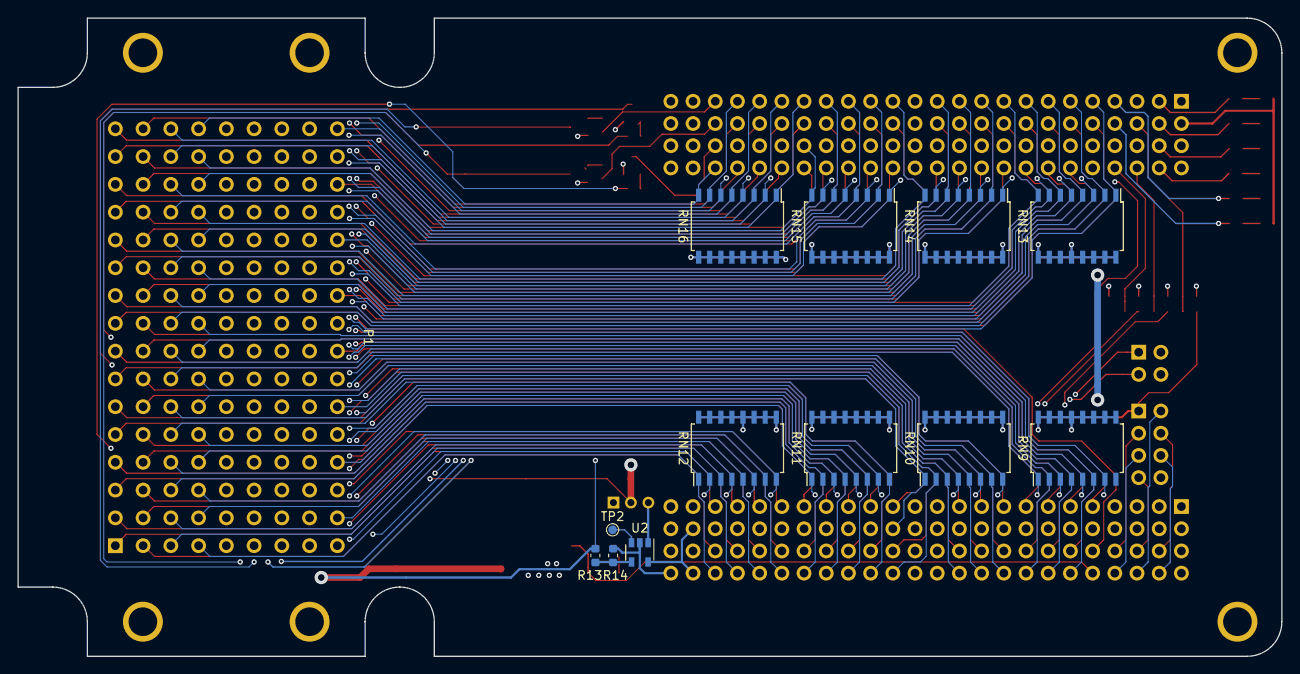
[picture p7: board agc_monitor.kicad_pcb from below]

Board: 4 copper layers, 144.6 x 73.0 mm, 66 parts (14 on the bottom side), 174 nets.
