thewonderidiot/agc_monitor/fpga/agc_monitor.runs/synth_1/.Xil/agc_monitor_propImpl.xdc

set_property SRC_FILE_INFO {cfile:/home/mike/agc_monitor/fpga/agc_monitor.srcs/constrs_1/new/agc_monitor.xdc rfile:../../../agc_monitor.srcs/constrs_1/new/agc_monitor.xdc id:1} [current_design]
set_property src_info {type:XDC file:1 line:2 export:INPUT save:INPUT read:READ} [current_design]
set_property PACKAGE_PIN Y6 [get_ports clk]
set_property src_info {type:XDC file:1 line:23 export:INPUT save:INPUT read:READ} [current_design]
set_property PACKAGE_PIN U20 [get_ports oe_n]
set_property src_info {type:XDC file:1 line:24 export:INPUT save:INPUT read:READ} [current_design]
set_property PACKAGE_PIN L18 [get_ports clkout]
set_property src_info {type:XDC file:1 line:25 export:INPUT save:INPUT read:READ} [current_design]
set_property PACKAGE_PIN Y20 [get_ports rd_n]
set_property src_info {type:XDC file:1 line:26 export:INPUT save:INPUT read:READ} [current_design]
set_property PACKAGE_PIN W20 [get_ports rxf_n]
set_property src_info {type:XDC file:1 line:27 export:INPUT save:INPUT read:READ} [current_design]
set_property PACKAGE_PIN V20 [get_ports siwu]
set_property src_info {type:XDC file:1 line:28 export:INPUT save:INPUT read:READ} [current_design]
set_property PACKAGE_PIN Y21 [get_ports txe_n]
set_property src_info {type:XDC file:1 line:29 export:INPUT save:INPUT read:READ} [current_design]
set_property PACKAGE_PIN W21 [get_ports wr_n]
set_property src_info {type:XDC file:1 line:31 export:INPUT save:INPUT read:READ} [current_design]
set_property PACKAGE_PIN T22 [get_ports {data[0]}]
set_property src_info {type:XDC file:1 line:32 export:INPUT save:INPUT read:READ} [current_design]
set_property PACKAGE_PIN T21 [get_ports {data[1]}]
set_property src_info {type:XDC file:1 line:33 export:INPUT save:INPUT read:READ} [current_design]
set_property PACKAGE_PIN U22 [get_ports {data[2]}]
set_property src_info {type:XDC file:1 line:34 export:INPUT save:INPUT read:READ} [current_design]
set_property PACKAGE_PIN U21 [get_ports {data[3]}]
set_property src_info {type:XDC file:1 line:35 export:INPUT save:INPUT read:READ} [current_design]
set_property PACKAGE_PIN V22 [get_ports {data[4]}]
set_property src_info {type:XDC file:1 line:36 export:INPUT save:INPUT read:READ} [current_design]
set_property PACKAGE_PIN W22 [get_ports {data[5]}]
set_property src_info {type:XDC file:1 line:37 export:INPUT save:INPUT read:READ} [current_design]
set_property PACKAGE_PIN AA22 [get_ports {data[6]}]
set_property src_info {type:XDC file:1 line:38 export:INPUT save:INPUT read:READ} [current_design]
set_property PACKAGE_PIN AB22 [get_ports {data[7]}]
set_property src_info {type:XDC file:1 line:82 export:INPUT save:INPUT read:READ} [current_design]
set_property PACKAGE_PIN AA16 [get_ports mnhnc]
set_property src_info {type:XDC file:1 line:83 export:INPUT save:INPUT read:READ} [current_design]
set_property PACKAGE_PIN P17 [get_ports monwt]
set_property src_info {type:XDC file:1 line:84 export:INPUT save:INPUT read:READ} [current_design]
set_property PACKAGE_PIN J18 [get_ports mrgg]
set_property src_info {type:XDC file:1 line:85 export:INPUT save:INPUT read:READ} [current_design]
set_property PACKAGE_PIN L17 [get_ports mwag]
set_property src_info {type:XDC file:1 line:86 export:INPUT save:INPUT read:READ} [current_design]
set_property PACKAGE_PIN R16 [get_ports mwbg]
set_property src_info {type:XDC file:1 line:87 export:INPUT save:INPUT read:READ} [current_design]
set_property PACKAGE_PIN F22 [get_ports mwg]
set_property src_info {type:XDC file:1 line:103 export:INPUT save:INPUT read:READ} [current_design]
set_property PACKAGE_PIN D20 [get_ports mgojam]
set_property src_info {type:XDC file:1 line:104 export:INPUT save:INPUT read:READ} [current_design]
set_property PACKAGE_PIN B22 [get_ports mnisq]
set_property src_info {type:XDC file:1 line:105 export:INPUT save:INPUT read:READ} [current_design]
set_property PACKAGE_PIN V18 [get_ports mpal_n]
set_property src_info {type:XDC file:1 line:106 export:INPUT save:INPUT read:READ} [current_design]
set_property PACKAGE_PIN AA19 [get_ports mrch]
set_property src_info {type:XDC file:1 line:107 export:INPUT save:INPUT read:READ} [current_design]
set_property PACKAGE_PIN K18 [get_ports mscafl_n]
set_property src_info {type:XDC file:1 line:108 export:INPUT save:INPUT read:READ} [current_design]
set_property PACKAGE_PIN N15 [get_ports mstp]
set_property src_info {type:XDC file:1 line:109 export:INPUT save:INPUT read:READ} [current_design]
set_property PACKAGE_PIN W17 [get_ports mstrt]
set_property src_info {type:XDC file:1 line:110 export:INPUT save:INPUT read:READ} [current_design]
set_property PACKAGE_PIN Y18 [get_ports mtcal_n]
set_property src_info {type:XDC file:1 line:111 export:INPUT save:INPUT read:READ} [current_design]
set_property PACKAGE_PIN U9 [get_ports mvfail_n]
set_property src_info {type:XDC file:1 line:112 export:INPUT save:INPUT read:READ} [current_design]
set_property PACKAGE_PIN B15 [get_ports mwatch_n]
set_property src_info {type:XDC file:1 line:113 export:INPUT save:INPUT read:READ} [current_design]
set_property PACKAGE_PIN W12 [get_ports mwch]
set_property src_info {type:XDC file:1 line:135 export:INPUT save:INPUT read:READ} [current_design]
set_property PACKAGE_PIN AA9 [get_ports {mbr[2]}]
set_property src_info {type:XDC file:1 line:138 export:INPUT save:INPUT read:READ} [current_design]
set_property PACKAGE_PIN Y8 [get_ports {mbr[1]}]
set_property src_info {type:XDC file:1 line:148 export:INPUT save:INPUT read:READ} [current_design]
set_property PACKAGE_PIN W11 [get_ports miip]
set_property src_info {type:XDC file:1 line:149 export:INPUT save:INPUT read:READ} [current_design]
set_property PACKAGE_PIN B16 [get_ports minhl]
set_property src_info {type:XDC file:1 line:150 export:INPUT save:INPUT read:READ} [current_design]
set_property PACKAGE_PIN C15 [get_ports minkl]
set_property src_info {type:XDC file:1 line:151 export:INPUT save:INPUT read:READ} [current_design]
set_property PACKAGE_PIN N17 [get_ports mstpit_n]
set_property src_info {type:XDC file:1 line:159 export:INPUT save:INPUT read:READ} [current_design]
set_property PACKAGE_PIN J17 [get_ports mrulog]
set_property src_info {type:XDC file:1 line:162 export:INPUT save:INPUT read:READ} [current_design]
set_property PACKAGE_PIN E21 [get_ports msp]
set_property src_info {type:XDC file:1 line:163 export:INPUT save:INPUT read:READ} [current_design]
set_property PACKAGE_PIN F18 [get_ports mgp_n]
set_property src_info {type:XDC file:1 line:175 export:INPUT save:INPUT read:READ} [current_design]
set_property PACKAGE_PIN A18 [get_ports mldch]
set_property src_info {type:XDC file:1 line:179 export:INPUT save:INPUT read:READ} [current_design]
set_property PACKAGE_PIN D18 [get_ports mrdch]
set_property src_info {type:XDC file:1 line:183 export:INPUT save:INPUT read:READ} [current_design]
set_property PACKAGE_PIN AB16 [get_ports mtcsa_n]
set_property src_info {type:XDC file:1 line:186 export:INPUT save:INPUT read:READ} [current_design]
set_property PACKAGE_PIN U17 [get_ports mtcsai]
set_property src_info {type:XDC file:1 line:235 export:INPUT save:INPUT read:READ} [current_design]
set_property PACKAGE_PIN G20 [get_ports p4sw_p]
set_property src_info {type:XDC file:1 line:236 export:INPUT save:INPUT read:READ} [current_design]
set_property PACKAGE_PIN Y9 [get_ports {mdt[1]}]
set_property src_info {type:XDC file:1 line:237 export:INPUT save:INPUT read:READ} [current_design]
set_property PACKAGE_PIN V13 [get_ports {mdt[5]}]
set_property src_info {type:XDC file:1 line:238 export:INPUT save:INPUT read:READ} [current_design]
set_property PACKAGE_PIN F21 [get_ports {mdt[9]}]
set_property src_info {type:XDC file:1 line:239 export:INPUT save:INPUT read:READ} [current_design]
set_property PACKAGE_PIN G17 [get_ports {mdt[13]}]
set_property src_info {type:XDC file:1 line:240 export:INPUT save:INPUT read:READ} [current_design]
set_property PACKAGE_PIN AA11 [get_ports {mdt[2]}]
set_property src_info {type:XDC file:1 line:241 export:INPUT save:INPUT read:READ} [current_design]
set_property PACKAGE_PIN Y19 [get_ports {mdt[6]}]
set_property src_info {type:XDC file:1 line:242 export:INPUT save:INPUT read:READ} [current_design]
set_property PACKAGE_PIN D22 [get_ports {mdt[10]}]
set_property src_info {type:XDC file:1 line:243 export:INPUT save:INPUT read:READ} [current_design]
set_property PACKAGE_PIN J16 [get_ports {mdt[14]}]
set_property src_info {type:XDC file:1 line:244 export:INPUT save:INPUT read:READ} [current_design]
set_property PACKAGE_PIN Y14 [get_ports {mdt[3]}]
set_property src_info {type:XDC file:1 line:245 export:INPUT save:INPUT read:READ} [current_design]
set_property PACKAGE_PIN W15 [get_ports {mdt[7]}]
set_property src_info {type:XDC file:1 line:246 export:INPUT save:INPUT read:READ} [current_design]
set_property PACKAGE_PIN A16 [get_ports {mdt[11]}]
set_property src_info {type:XDC file:1 line:247 export:INPUT save:INPUT read:READ} [current_design]
set_property PACKAGE_PIN U15 [get_ports {mdt[15]}]
set_property src_info {type:XDC file:1 line:248 export:INPUT save:INPUT read:READ} [current_design]
set_property PACKAGE_PIN AB14 [get_ports {mdt[4]}]
set_property src_info {type:XDC file:1 line:249 export:INPUT save:INPUT read:READ} [current_design]
set_property PACKAGE_PIN J20 [get_ports {mdt[8]}]
set_property src_info {type:XDC file:1 line:250 export:INPUT save:INPUT read:READ} [current_design]
set_property PACKAGE_PIN F16 [get_ports {mdt[12]}]
set_property src_info {type:XDC file:1 line:251 export:INPUT save:INPUT read:READ} [current_design]
set_property PACKAGE_PIN T4 [get_ports {mdt[16]}]
set_property src_info {type:XDC file:1 line:252 export:INPUT save:INPUT read:READ} [current_design]
set_property PACKAGE_PIN B20 [get_ports {msq[10]}]
set_property src_info {type:XDC file:1 line:253 export:INPUT save:INPUT read:READ} [current_design]
set_property PACKAGE_PIN D21 [get_ports {msq[13]}]
set_property src_info {type:XDC file:1 line:254 export:INPUT save:INPUT read:READ} [current_design]
set_property PACKAGE_PIN M16 [get_ports {msq[14]}]
set_property src_info {type:XDC file:1 line:255 export:INPUT save:INPUT read:READ} [current_design]
set_property PACKAGE_PIN C18 [get_ports {msq[11]}]
set_property src_info {type:XDC file:1 line:256 export:INPUT save:INPUT read:READ} [current_design]
set_property PACKAGE_PIN F19 [get_ports {msq[12]}]
set_property src_info {type:XDC file:1 line:257 export:INPUT save:INPUT read:READ} [current_design]
set_property PACKAGE_PIN R6 [get_ports {msq[15]}]
set_property src_info {type:XDC file:1 line:258 export:INPUT save:INPUT read:READ} [current_design]
set_property PACKAGE_PIN V9 [get_ports {mst[1]}]
set_property src_info {type:XDC file:1 line:259 export:INPUT save:INPUT read:READ} [current_design]
set_property PACKAGE_PIN Y10 [get_ports {mst[2]}]
set_property src_info {type:XDC file:1 line:260 export:INPUT save:INPUT read:READ} [current_design]
set_property PACKAGE_PIN AA13 [get_ports {mst[3]}]
set_property src_info {type:XDC file:1 line:261 export:INPUT save:INPUT read:READ} [current_design]
set_property PACKAGE_PIN AB11 [get_ports {mt[1]}]
set_property src_info {type:XDC file:1 line:262 export:INPUT save:INPUT read:READ} [current_design]
set_property PACKAGE_PIN AA18 [get_ports {mt[5]}]
set_property src_info {type:XDC file:1 line:263 export:INPUT save:INPUT read:READ} [current_design]
set_property PACKAGE_PIN C22 [get_ports {mt[9]}]
set_property src_info {type:XDC file:1 line:264 export:INPUT save:INPUT read:READ} [current_design]
set_property PACKAGE_PIN AA8 [get_ports {mt[2]}]
set_property src_info {type:XDC file:1 line:265 export:INPUT save:INPUT read:READ} [current_design]
set_property PACKAGE_PIN W13 [get_ports {mt[6]}]
set_property src_info {type:XDC file:1 line:266 export:INPUT save:INPUT read:READ} [current_design]
set_property PACKAGE_PIN C20 [get_ports {mt[10]}]
set_property src_info {type:XDC file:1 line:267 export:INPUT save:INPUT read:READ} [current_design]
set_property PACKAGE_PIN AA14 [get_ports {mt[3]}]
set_property src_info {type:XDC file:1 line:268 export:INPUT save:INPUT read:READ} [current_design]
set_property PACKAGE_PIN K21 [get_ports {mt[7]}]
set_property src_info {type:XDC file:1 line:269 export:INPUT save:INPUT read:READ} [current_design]
set_property PACKAGE_PIN A17 [get_ports {mt[11]}]
set_property src_info {type:XDC file:1 line:270 export:INPUT save:INPUT read:READ} [current_design]
set_property PACKAGE_PIN AB15 [get_ports {mt[4]}]
set_property src_info {type:XDC file:1 line:271 export:INPUT save:INPUT read:READ} [current_design]
set_property PACKAGE_PIN V19 [get_ports {mt[8]}]
set_property src_info {type:XDC file:1 line:272 export:INPUT save:INPUT read:READ} [current_design]
set_property PACKAGE_PIN E16 [get_ports {mt[12]}]
set_property src_info {type:XDC file:1 line:273 export:INPUT save:INPUT read:READ} [current_design]
set_property PACKAGE_PIN V10 [get_ports {mwl[1]}]
set_property src_info {type:XDC file:1 line:274 export:INPUT save:INPUT read:READ} [current_design]
set_property PACKAGE_PIN AA17 [get_ports {mwl[5]}]
set_property src_info {type:XDC file:1 line:275 export:INPUT save:INPUT read:READ} [current_design]
set_property PACKAGE_PIN P16 [get_ports {mwl[9]}]
set_property src_info {type:XDC file:1 line:276 export:INPUT save:INPUT read:READ} [current_design]
set_property PACKAGE_PIN G19 [get_ports {mwl[13]}]
set_property src_info {type:XDC file:1 line:277 export:INPUT save:INPUT read:READ} [current_design]
set_property PACKAGE_PIN AA12 [get_ports {mwl[2]}]
set_property src_info {type:XDC file:1 line:278 export:INPUT save:INPUT read:READ} [current_design]
set_property PACKAGE_PIN AA21 [get_ports {mwl[6]}]
set_property src_info {type:XDC file:1 line:279 export:INPUT save:INPUT read:READ} [current_design]
set_property PACKAGE_PIN B19 [get_ports {mwl[10]}]
set_property src_info {type:XDC file:1 line:280 export:INPUT save:INPUT read:READ} [current_design]
set_property PACKAGE_PIN M15 [get_ports {mwl[14]}]
set_property src_info {type:XDC file:1 line:281 export:INPUT save:INPUT read:READ} [current_design]
set_property PACKAGE_PIN Y11 [get_ports {mwl[3]}]
set_property src_info {type:XDC file:1 line:282 export:INPUT save:INPUT read:READ} [current_design]
set_property PACKAGE_PIN W16 [get_ports {mwl[7]}]
set_property src_info {type:XDC file:1 line:283 export:INPUT save:INPUT read:READ} [current_design]
set_property PACKAGE_PIN C17 [get_ports {mwl[11]}]
set_property src_info {type:XDC file:1 line:284 export:INPUT save:INPUT read:READ} [current_design]
set_property PACKAGE_PIN K19 [get_ports {mwl[15]}]
set_property src_info {type:XDC file:1 line:285 export:INPUT save:INPUT read:READ} [current_design]
set_property PACKAGE_PIN U12 [get_ports {mwl[4]}]
set_property src_info {type:XDC file:1 line:286 export:INPUT save:INPUT read:READ} [current_design]
set_property PACKAGE_PIN P20 [get_ports {mwl[8]}]
set_property src_info {type:XDC file:1 line:287 export:INPUT save:INPUT read:READ} [current_design]
set_property PACKAGE_PIN D16 [get_ports {mwl[12]}]
set_property src_info {type:XDC file:1 line:288 export:INPUT save:INPUT read:READ} [current_design]
set_property PACKAGE_PIN U10 [get_ports {mwl[16]}]
set_property src_info {type:XDC file:1 line:289 export:INPUT save:INPUT read:READ} [current_design]
set_property PACKAGE_PIN AB10 [get_ports mctral_n]
set_property src_info {type:XDC file:1 line:290 export:INPUT save:INPUT read:READ} [current_design]
set_property PACKAGE_PIN F17 [get_ports mload]
set_property src_info {type:XDC file:1 line:291 export:INPUT save:INPUT read:READ} [current_design]
set_property PACKAGE_PIN V12 [get_ports mnhrpt]
set_property src_info {type:XDC file:1 line:292 export:INPUT save:INPUT read:READ} [current_design]
set_property PACKAGE_PIN Y13 [get_ports mnhsbf]
set_property src_info {type:XDC file:1 line:293 export:INPUT save:INPUT read:READ} [current_design]
set_property PACKAGE_PIN Y15 [get_ports monpar]
set_property src_info {type:XDC file:1 line:294 export:INPUT save:INPUT read:READ} [current_design]
set_property PACKAGE_PIN R21 [get_ports monwbk]
set_property src_info {type:XDC file:1 line:295 export:INPUT save:INPUT read:READ} [current_design]
set_property PACKAGE_PIN K15 [get_ports mread]
set_property src_info {type:XDC file:1 line:296 export:INPUT save:INPUT read:READ} [current_design]
set_property PACKAGE_PIN B17 [get_ports mreqin]
set_property src_info {type:XDC file:1 line:297 export:INPUT save:INPUT read:READ} [current_design]
set_property PACKAGE_PIN AB19 [get_ports mrptal_n]
set_property src_info {type:XDC file:1 line:298 export:INPUT save:INPUT read:READ} [current_design]
set_property PACKAGE_PIN P15 [get_ports mscdbl_n]
set_property src_info {type:XDC file:1 line:299 export:INPUT save:INPUT read:READ} [current_design]
set_property PACKAGE_PIN K20 [get_ports msqext]
set_property src_info {type:XDC file:1 line:300 export:INPUT save:INPUT read:READ} [current_design]
set_property PACKAGE_PIN U4 [get_ports mwbbeg]
set_property src_info {type:XDC file:1 line:301 export:INPUT save:INPUT read:READ} [current_design]
set_property PACKAGE_PIN U16 [get_ports mwebg]
set_property src_info {type:XDC file:1 line:302 export:INPUT save:INPUT read:READ} [current_design]
set_property PACKAGE_PIN P18 [get_ports mwfbg]
set_property src_info {type:XDC file:1 line:303 export:INPUT save:INPUT read:READ} [current_design]
set_property PACKAGE_PIN G15 [get_ports mwlg]
set_property src_info {type:XDC file:1 line:304 export:INPUT save:INPUT read:READ} [current_design]
set_property PACKAGE_PIN P21 [get_ports mwqg]
set_property src_info {type:XDC file:1 line:305 export:INPUT save:INPUT read:READ} [current_design]
set_property PACKAGE_PIN U11 [get_ports mwsg]
set_property src_info {type:XDC file:1 line:306 export:INPUT save:INPUT read:READ} [current_design]
set_property PACKAGE_PIN Y16 [get_ports mwyg]
set_property src_info {type:XDC file:1 line:307 export:INPUT save:INPUT read:READ} [current_design]
set_property PACKAGE_PIN AB21 [get_ports mwzg]
set_property src_info {type:XDC file:1 line:308 export:INPUT save:INPUT read:READ} [current_design]
set_property PACKAGE_PIN P22 [get_ports nhalga]
set_property src_info {type:XDC file:1 line:309 export:INPUT save:INPUT read:READ} [current_design]
set_property PACKAGE_PIN Y5 [get_ports rst_n]
set_property src_info {type:XDC file:1 line:317 export:INPUT save:INPUT read:READ} [current_design]
set_property PACKAGE_PIN A19 [get_ports dbltst]
set_property src_info {type:XDC file:1 line:318 export:INPUT save:INPUT read:READ} [current_design]
set_property PACKAGE_PIN C19 [get_ports doscal]
set_property src_info {type:XDC file:1 line:323 export:INPUT save:INPUT read:READ} [current_design]
set_property PACKAGE_PIN U5 [get_ports nhstrt1]
set_property src_info {type:XDC file:1 line:324 export:INPUT save:INPUT read:READ} [current_design]
set_property PACKAGE_PIN U6 [get_ports nhstrt2]
set_property src_info {type:XDC file:1 line:327 export:INPUT save:INPUT read:READ} [current_design]
set_property PACKAGE_PIN M17 [get_ports moscal_n]
set_property src_info {type:XDC file:1 line:329 export:INPUT save:INPUT read:READ} [current_design]
set_property PACKAGE_PIN V15 [get_ports mpipal_n]
set_property src_info {type:XDC file:1 line:331 export:INPUT save:INPUT read:READ} [current_design]
set_property PACKAGE_PIN D17 [get_ports mwarnf_n]
set_property src_info {type:XDC file:1 line:334 export:INPUT save:INPUT read:READ} [current_design]
set_property PACKAGE_PIN R19 [get_ports mrsc]
set_property src_info {type:XDC file:1 line:338 export:INPUT save:INPUT read:READ} [current_design]
set_property PACKAGE_PIN AB20 [get_ports mamu]
set_property src_info {type:XDC file:1 line:364 export:INPUT save:INPUT read:READ} [current_design]
set_property PACKAGE_PIN J22 [get_ports {leds[1]}]
set_property src_info {type:XDC file:1 line:365 export:INPUT save:INPUT read:READ} [current_design]
set_property PACKAGE_PIN J21 [get_ports {leds[2]}]
set_property src_info {type:XDC file:1 line:366 export:INPUT save:INPUT read:READ} [current_design]
set_property PACKAGE_PIN H20 [get_ports {leds[5]}]
set_property src_info {type:XDC file:1 line:367 export:INPUT save:INPUT read:READ} [current_design]
set_property PACKAGE_PIN H19 [get_ports {leds[6]}]
set_property src_info {type:XDC file:1 line:368 export:INPUT save:INPUT read:READ} [current_design]
set_property PACKAGE_PIN L22 [get_ports {leds[3]}]
set_property src_info {type:XDC file:1 line:369 export:INPUT save:INPUT read:READ} [current_design]
set_property PACKAGE_PIN L21 [get_ports {leds[4]}]
set_property src_info {type:XDC file:1 line:370 export:INPUT save:INPUT read:READ} [current_design]
set_property PACKAGE_PIN M22 [get_ports {dbg[1]}]
set_property src_info {type:XDC file:1 line:371 export:INPUT save:INPUT read:READ} [current_design]
set_property PACKAGE_PIN N19 [get_ports {dbg[2]}]
set_property src_info {type:XDC file:1 line:372 export:INPUT save:INPUT read:READ} [current_design]
set_property PACKAGE_PIN M19 [get_ports {dbg[3]}]
set_property src_info {type:XDC file:1 line:373 export:INPUT save:INPUT read:READ} [current_design]
set_property PACKAGE_PIN N20 [get_ports {dbg[4]}]
set_property src_info {type:XDC file:1 line:374 export:INPUT save:INPUT read:READ} [current_design]
set_property PACKAGE_PIN M20 [get_ports {dbg[5]}]
set_property src_info {type:XDC file:1 line:375 export:INPUT save:INPUT read:READ} [current_design]
set_property PACKAGE_PIN M21 [get_ports {dbg[6]}]
