thewonderidiot/agc_monitor/fpga/agc_monitor.srcs/sources_1/new/peripheral_instructions.v

`timescale 1ns / 1ps
`default_nettype none
`include "monitor_defs.v"

module peripheral_instructions(
    input wire clk,
    input wire rst_n,

    input wire monwt,
    input wire [12:1] mt,
    input wire [3:1] mst,
    input wire [16:1] mwl,
    input wire msp,

    output wire inhibit_mstp,
    output reg inhibit_ws,
    output wire rbbk,

    input wire mreqin,
    input wire mtcsa_n,

    input wire load,
    input wire read,
    input wire loadch,
    input wire readch,
    input wire tcsaj,

    input wire [15:1] bb,
    input wire [12:1] s,
    input wire [15:0] data,

    output reg [16:1] read_data,
    output reg read_parity,
    output wire complete,

    output wire mtcsai,
    output wire mread,
    output wire mload,
    output wire mrdch,
    output wire mldch,
    output wire monwbk,

    output reg [16:1] mdt
);

localparam IDLE = 0,
           WAIT_MREQ_DONE = 1,
           REQUEST = 2,
           ALLOW_MCT = 3,
           READ = 4,
           LOAD = 5,
           READCH = 6,
           LOADCH = 7,
           TCSAJ = 8,
           COMPLETE = 9;

`define PERIPH_TIMEOUT_COUNT 9375 // Eight MCTs
`define PERIPH_MAX_T12S 3

reg [3:0] state;
reg [3:0] next_state;

reg [4:0] request;
reg [4:0] request_q;

reg [15:1] req_bb;
reg [15:1] req_bb_q;

reg [12:1] req_s;
reg [12:1] req_s_q;

reg [15:0] req_data;
reg [15:0] req_data_q;

reg [15:0] read_data_q;
reg read_parity_q;

assign mtcsai = request[0];
assign mrdch = request[1];
assign mldch = request[2];
assign mread = request[3];
assign mload = request[4];

assign inhibit_mstp = (state != IDLE) && (state != WAIT_MREQ_DONE) && (state != REQUEST);
assign monwbk = (state == LOAD) & ((req_s == `EB) | (req_s == `FB) | (req_s == `BB));
assign rbbk = ((state == LOAD) | (state == READ)) & (mst == 3'd1) & mt[10];

assign complete = (state == COMPLETE);

reg [13:0] timer;
always @(posedge clk or negedge rst_n) begin
    if (~rst_n) begin
        timer <= 14'b0;
    end else begin
        if (state == IDLE) begin
            timer <= 14'b0;
        end else if (timer < `PERIPH_TIMEOUT_COUNT) begin
            timer <= timer + 1;
        end
    end
end

reg mt12_q;
reg [1:0] t12_starts;
always @(posedge clk or negedge rst_n) begin
    if (~rst_n) begin
        mt12_q <= 1'b0;
        t12_starts <= 2'b0;
    end else begin
        mt12_q <= mt[12];
        if (state == REQUEST) begin
            if ((t12_starts < `PERIPH_MAX_T12S) & ~mt12_q & mt[12]) begin
                t12_starts <= t12_starts + 1;
            end
        end else begin
            t12_starts <= 2'b0;
        end
    end
end

always @(*) begin
    inhibit_ws = 1'b0;
    case (state)
    READ,LOAD: begin
        if (mst == 3'd1) inhibit_ws = 1;
    end

    READCH,LOADCH: begin
        if (mt[8]) inhibit_ws = 1;
    end
    endcase
end

always @(*) begin
    mdt = 16'b0;
    read_data_q = read_data;
    read_parity_q = read_parity;
    case (state)
    READ,LOAD: begin
        if (mst == 3'd0) begin
            if (mt[4]) mdt = {req_bb[15], req_bb};
            if (mt[8]) mdt = {4'b0, req_s};
        end else begin
            if ((state == READ) & mt[7]) begin
                read_data_q = mwl;
                read_parity_q = msp;
            end
            if ((state == LOAD) & (mt[4] | mt[9])) mdt = req_data;
        end
    end

    READCH,LOADCH: begin
        if (mt[1]) mdt = {4'b0, req_s};
        if ((state == READCH) & mt[5]) read_data_q = mwl;
        if ((state == LOADCH) & mt[7]) mdt = req_data;
    end

    TCSAJ: begin
        if (mt[8]) mdt = {4'b0, req_s};
    end
    endcase
end

always @(*) begin
    request_q = 5'b0;
    next_state = state;
    req_bb_q = req_bb;
    req_s_q = req_s;
    req_data_q = req_data;

    if (state == IDLE) begin
        if (load | read | loadch | readch | tcsaj) begin
            next_state = WAIT_MREQ_DONE;
            req_bb_q = bb;
            req_s_q = s;
            req_data_q = data;
        end
    end else if (state == COMPLETE) begin
        next_state = IDLE;
    end else if (timer < `PERIPH_TIMEOUT_COUNT) begin
        request_q = request;
        case (state)
        WAIT_MREQ_DONE: begin
            if (~mreqin) begin
                request_q = {load, read, loadch, readch, tcsaj};
                next_state = REQUEST;
            end
        end

        REQUEST: begin
            if (t12_starts >= `PERIPH_MAX_T12S) begin
                next_state = ALLOW_MCT;
            end else begin
                if (mreqin) begin
                    if (mread) begin
                        next_state = READ;
                    end else if (mload) begin
                        next_state = LOAD;
                    end else if (mrdch) begin
                        next_state = READCH;
                    end else begin
                        next_state = LOADCH;
                    end
                end else if (~mtcsa_n & monwt & mt[12]) begin
                    next_state = TCSAJ;
                end
            end
        end

        ALLOW_MCT: begin
            if (mt[1]) begin
                next_state = REQUEST;
            end
        end

        READ,LOAD: begin
            if ((mst == 3'b1) & mt[11]) begin
                next_state = COMPLETE;
            end
        end

        READCH,LOADCH,TCSAJ: begin
            if (mt[9]) begin
                next_state = COMPLETE;
            end
        end
        endcase
    end else begin
        next_state = COMPLETE;
    end
end

always @(posedge clk or negedge rst_n) begin
    if (~rst_n) begin
        state <= IDLE;
        request <= 5'b0;
        req_bb <= 15'b0;
        req_s <= 12'b0;
        read_data <= 16'b0;
        req_data <= 16'b0;
        read_parity <= 1'b0;
    end else begin
        state <= next_state;
        request <= request_q;
        req_bb <= req_bb_q;
        req_s <= req_s_q;
        read_data <= read_data_q;
        read_parity <= read_parity_q;
        req_data <= req_data_q;
    end
end

endmodule
`default_nettype wire
