thewonderidiot/agc_monitor/fpga/agc_monitor.srcs/sources_1/new/io_circuits.v

`timescale 1ns / 1ps
`default_nettype none

module io_circuits(
    input wire clk,
    input wire rst_n,

    // Debounced inputs
    input wire mstpit_n,
    input wire monwt,
    input wire [12:1] mt,
    input wire [16:1] mwl,
    input wire miip,
    input wire minhl,
    input wire minkl,
    input wire msqext,
    input wire [15:10] msq,
    input wire [3:1] mst,
    input wire [2:1] mbr,
    input wire mrsc,
    input wire mwag,
    input wire mwlg,
    input wire mwqg,
    input wire mwebg,
    input wire mwfbg,
    input wire mwbbeg,
    input wire mwzg,
    input wire mwbg,
    input wire mwsg,
    input wire mwg,
    input wire mwyg,
    input wire mrulog,
    input wire mrgg,
    input wire mrch,
    input wire mwch,
    input wire mnisq,
    input wire msp,
    input wire mgp_n,
    input wire mreqin,
    input wire mtcsa_n,

    output wire mstpit_n_db,
    output wire monwt_db,
    output wire [12:1] mt_db,
    output wire [16:1] mwl_db,
    output wire miip_db,
    output wire minhl_db,
    output wire minkl_db,
    output wire msqext_db,
    output wire [15:10] msq_db,
    output wire [3:1] mst_db,
    output wire [2:1] mbr_db,
    output wire mrsc_db,
    output wire mwag_db,
    output wire mwlg_db,
    output wire mwqg_db,
    output wire mwebg_db,
    output wire mwfbg_db,
    output wire mwbbeg_db,
    output wire mwzg_db,
    output wire mwbg_db,
    output wire mwsg_db,
    output wire mwg_db,
    output wire mwyg_db,
    output wire mrulog_db,
    output wire mrgg_db,
    output wire mrch_db,
    output wire mwch_db,
    output wire mnisq_db,
    output wire msp_db,
    output wire mgp_n_db,
    output wire mreqin_db,
    output wire mtcsa_n_db,

    // Open-drain outputs
    input wire mnhsbf_pp,
    input wire mamu_pp,
    input wire [16:1] mdt_pp,
    input wire monpar_pp,
    input wire mstrt_pp,
    input wire mstp_pp,
    input wire mnhrpt_pp,
    input wire mnhnc_pp,
    input wire nhalga_pp,
    input wire doscal_pp,
    input wire dbltst_pp,
    input wire mread_pp,
    input wire mload_pp,
    input wire mrdch_pp,
    input wire mldch_pp,
    input wire mtcsai_pp,
    input wire monwbk_pp,

    output wire mnhsbf,
    output wire mamu,
    output wire [16:1] mdt,
    output wire monpar,
    output wire mstrt,
    output wire mstp,
    output wire mnhrpt,
    output wire mnhnc,
    output wire nhalga,
    output wire doscal,
    output wire dbltst,
    output wire mread,
    output wire mload,
    output wire mrdch,
    output wire mldch,
    output wire mtcsai,
    output wire monwbk
);
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
