thewonderidiot/agc_monitor/(commit log)

2018-12-29 Minor reorganization to make room for the other pieces of the project (the PCB and the client)
2019-01-01 Added the basic read/TX chain, which appears to work in simulation but has not yet been tried on hardware
2019-01-01 Made use of FIFO full flags to stall the TX/RX pipelines in some places
    [msg_sender.v, usb_interface.v]
2019-01-02 Fixed some timing issues with the USB interface (which can probably be further cleaned up). Reads now working on actual hardware.
    [agc_monitor_tb.v, read_byte_fifo.v, read_byte_fifo.vhd, read_byte_fifo_sim_netlist.v, read_byte_fifo_stub.v, usb_interface.v]
2019-01-06 Pin assignments for what I have so far
2019-01-07 Initial boardery (test connector symbol and footprint)
    [_saved_agc_monitor.sch, agc_monitor.kicad_pcb, agc_monitor.sch]
2019-01-14 Symbol and footprint for the Styx main connectors, plus an extremely preliminary schematic
    [_saved_agc_monitor.sch, agc_monitor.kicad_pcb, agc_monitor.sch, styx_connectors.sch, test_connector.sch]
2019-01-19 Client: added a simple pub/sub interface to the USB thread, and made the simple comp stop panel use it
2019-01-21 Client: added remaining COMP STOP switches and moved address decoding into an AGC support library, along with disassembly
2019-01-22 Client: Implemented S1 and S2 switch banks; S1/S2 selection switches to follow
2019-01-23 FPGA: filter out transients on SQ during MSTP to fix flickering on the monitor display
    [agc_monitor.v, monitor_regs.v]
2019-01-23 Client: added an S1/S2 switch to the comp stop panel, tweaked USB polling, and filled in stop cause bits
2019-01-26 Client: Added the W comparator switches
2019-01-26 Client: added I comparator switches
2019-01-28 FPGA: Added ADC inputs for the 3 analog channels (BPLSSW and +4SW voltage, MTHI/MTLO resistance)
2019-01-28 FPGA: Added a simple module for DSKY simulation and fixed a bug in channel definitions
    [agc_monitor.v, agc_monitor.xdc, cmd_controller.v, monitor_channels.v, monitor_defs.v, monitor_dsky.v]
2019-02-04 Client: added functionality to most of the read/load/start switches
2019-02-07 FPGA: Fixed some bugs related to peripheral instructions
    [control_regs.v, peripheral_instructions.v]
2019-02-07 Client: look specifically for Styx boards with a custom serial number
2019-02-07 FPGA: Implemented BANK-S/S-ONLY and ADV S switches
2019-02-09 Client: added buttons to the DSKY, and specs for their messages
2019-02-09 Client: removed a debug print
2019-02-10 FPGA: added DSKY buttons (minus pro) and status lights
2019-02-10 FPGA: several tweaks to make keypresses more reliable (they were sometimes crashing the AGC before)
    [agc_monitor.v, channel.v, monitor_channels.v, monitor_defs.v, monitor_dsky.v, monitor_regs.v, restart_monitor.v, start_stop.v]
2019-02-12 FPGA: added a module for reading fixed memory via periphal instructions. It doesn't consistently get the same results on successive bank dumps, and so needs debugging, but it is close.
    [agc_fixed.v, agc_monitor.v, cmd_controller.v, fixed_addr_encoder.v]
2019-02-13 FPGA: Added debounce interface circuits for most inputs from the AGC. All intermittent issues have vanished, and so were likely due to signal integrity on my test setup
    [agc_monitor.v, agc_monitor.xdc, agc_monitor_propImpl.xdc, agc_monitor_tb.v, cmd_fifo.v, cmd_fifo.vhd, cmd_fifo_sim_netlist.v, cmd_fifo_stub.v]
2019-02-15 Client: rewrote backend to use a QThread, so that other threads (e.g. memory dump threads) work safely
2019-02-19 Board: initial schematic for the monitor interface board
    [agc_monitor.sch, interface_circuits.sch, styx_connectors.sch, test_connector.sch]
2019-02-25 Board: minor schematic tweaks, footprint creation, and initial subcircuit layout
    [agc_monitor.kicad_pcb, interface_circuits.sch, styx_connectors.sch, test_connector.sch]
2019-03-04 Board: minor redesign and initial ideas for layout
    [agc_monitor.kicad_pcb, interface_circuits.sch, styx_connectors.sch]
2019-03-05 Board: a bit more layout work on TC breakout
    [agc_monitor.kicad_pcb, interface_circuits.sch]
2019-03-08 Board: a couple more power supply changes, and completed initial TC breakout
    [interface_circuits.sch]
2019-03-11 Board: more layout work
    [agc_monitor.kicad_pcb, interface_circuits.sch]
2019-03-13 Board: lots of work routing connector J4. It's almost fully wired up; J5 is next.
    [agc_monitor.kicad_pcb, styx_connectors.sch]
2019-03-14 Board: completed routing of AGC signals to RNs and FPGA pins
    [agc_monitor.kicad_pcb, styx_connectors.sch]
2019-03-14 Board: Added initial rouuting of 3.3V I/O power
    [agc_monitor.kicad_pcb]
2019-03-15 Board: Thinner traces for SI, more layout work, and some 3D models of parts
    [agc_monitor.kicad_pcb, styx_connectors.sch]
2019-03-17 Redid the mechanical outline of the board; further development/layout
    [agc_monitor.kicad_pcb, interface_circuits.sch, styx_connectors.sch, test_connector.sch]
2019-03-18 Board: completed initial layout
    [agc_monitor.kicad_pcb, styx_connectors.sch]
2019-03-19 Board: initial rearranging to allow for a cover
    [styx_connectors.sch]
2019-03-20 Board: more rearranging work on the front; a bit more yet to come
    [agc_monitor.kicad_pcb, interface_circuits.sch, styx_connectors.sch]
2019-03-22 Board: Reshaped and relocated some components; board may extend soon to allow a cover to neck in
    [agc_monitor.kicad_pcb, styx_connectors.sch]
2019-03-24 Board: finalized v1.1 (barring any last-minute tweaks)
    [agc_monitor.kicad_pcb, interface_circuits.sch, styx_connectors.sch]
2019-04-02 Board: changed the SIGNY transistor to MMBT2369 since the 3904 has slow saturation recovery
    [agc_monitor.kicad_pcb, interface_circuits.sch]
2019-04-02 FPGA: Reassigned pins to match the board, and added the fourth ADC channel. Outputs still need to be OD-buffered
2019-04-03 FPGA: added open-drain buffers to all of the outputs, and reorganized all of the interface circuits into their own module
2019-04-03 FPGA project updates for board compatibility
2019-04-05 Board: increased LDO output capacitor to 22uF to improve stability
    [interface_circuits.sch]
2019-04-08 FPGA: Added a new 'status' group that handles the ADC and will handle the alarms
2019-04-09 Board: increased AGC temperature sense resistor to 1.5k to increase ADC sensitivity
    [agc_monitor.sch, interface_circuits.sch, styx_connectors.sch, test_connector.sch]
2019-04-09 Client: corrected calculations for AGC temperature
    [monitor.cfg]
2019-04-09 FPGA: Added set and reset logic for all of the alarms
    [agc_monitor.v, monitor.v, status_regs.v]
2019-04-09 FPGA: Board project updates for measurements and alarms
2019-04-13 FPGA: Corrected CRS data bit assignments
    [core_rope_sim.v]
2019-04-15 FPGA: Added LED and debug connector pins
2019-04-15 Wired up the LD/LDCH/RD/RDCH indicator lights
2019-04-20 FPGA: Corrected pin mapping for MDT03
    [agc_monitor.xdc, agc_monitor_propImpl.xdc]
2019-04-20 Board: corrected Styx symbol to show Y14 instead of Y4
    [styx_connectors.sch]
2019-04-22 FPGA: More improvements to peripheral instructions. They now wait a bit longer for MREQIN to latch, and can time out if too much total time is taken (which keeps the FPGA from locking up)
    [peripheral_instructions.v]
2019-04-23 FPGA: More bugfixes (ignore IO/DV determination during counts for EMS cycles, only write to W parity if writing to W, and fixed epal/fpal assignments)
    [erasable_mem_sim.v, monitor.v, monitor_regs.v, status_regs.v]
2019-04-27 FPGA: Added an instruction trace buffer
2019-04-27 FPGA: A couple of bugfixes for the trace buffer
    [instruction_trace.v, monitor.v]
2019-04-27 Client: preliminary instruction trace panel
2019-04-27 Increased trace depth to 16384 instructions and improved the UI a bit
2019-04-28 FPGA: Keep 'true' copies of EB, FB, and S for use with memory simulation, so peripheral instructions don't screw things up
2019-06-29 FPGA: Added support for constant comparison of AGC-read rope data and simulated rope data, for detecting errors in reading ropes
    [core_rope_sim.v, monitor.v, monitor_defs.v, status_regs.v]
2019-07-07 FPGA: enable internal writing to simulated memory, to prevent NASSP from needing to use apparently buggy peripheral instructions
    [erasable_mem_sim.v, monitor.v, nassp_bridge.v, ps7_init.c, ps7_init_gpl.c]
2019-07-08 FPGA: Generalized interrupt injection to support other types of interrupts
2019-07-09 FPGA: Fixed output counter integration. Crosspointers now work as expected.
    [output_counter.v]
2021-01-08 FPGA: Added a couple of HWDEF files apparently needed for building
2021-01-11 FPGA: A couple more missing files; fsbl_bsp should hopefully build now
