thewonderidiot/agc_monitor/(notices)

Notices in the files:
fpga/agc_monitor.srcs/sources_1/bd/monitor_ps/ip/monitor_ps_processing_system7_0_0/hdl/verilog/processing_system7_v5_5_processing_system7.v:
This file contains proprietary and confidential information of
Xilinx, Inc. ("Xilinx"), that is distributed under a license
Copyright 2010 Xilinx, Inc.
All rights reserved.
